superobk/microduck-cad/projects/microduck-stand/README.md

# Microduck Stand

用于 Microduck 的静态支承、姿态检查和校准准备工装。

| 版本 | 适配与状态 | 入口 |
| --- | --- | --- |
| JIG-190 R5 Compact Full15 / R5.0-rc1 | 完整 15 舵机；190 × 190 mm 底座；数字样机候选版 | [打印文件与中文使用说明](r5-compact-full15/README.md) |

R5 与 R4 接口和脚高不同，请使用同一版本目录中的全套零件。后续版本在本目录新增独立子目录，并更新本表。
