superobk/microduck-cad/projects/microduck-stand/r5-compact-full15/stl/01_integrated_main_190.stl

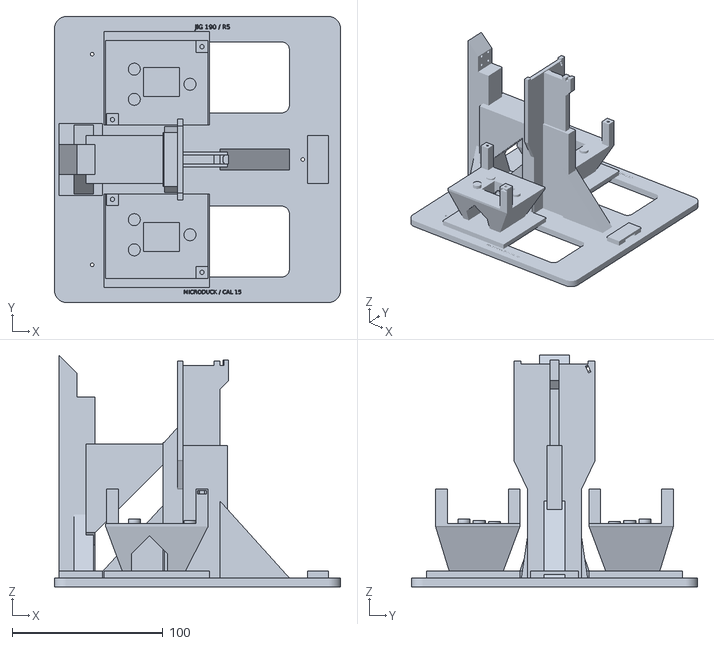
[picture p3: CAD file, 2026-11-02]
projects/microduck-stand/r5-compact-full15/stl/01_integrated_main_190.stl
190.0 x 190.0 x 154.0
