superobk/microduck-cad/projects/microduck-stand/r5-compact-full15/printing/Microduck_JIG190_R5_P1S_PLA_PREPARE.3mf

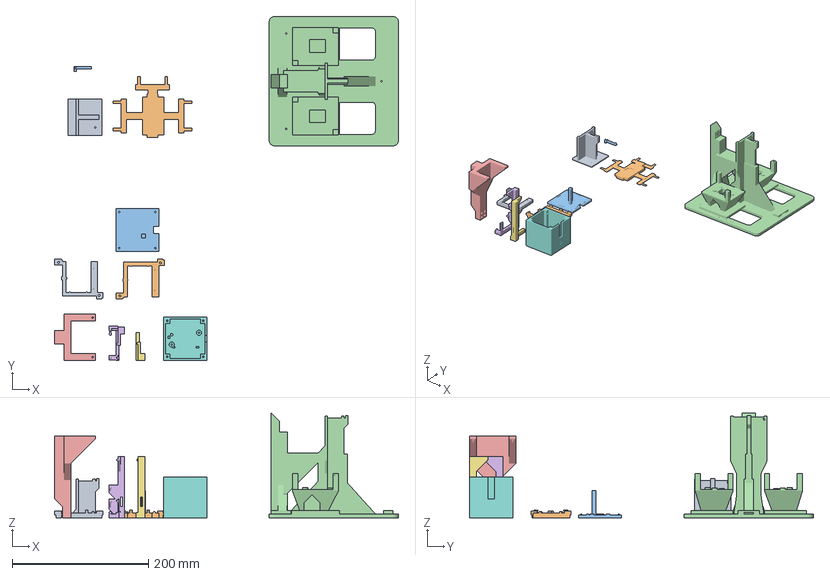
[picture p4: CAD file, 2026-11-02]
projects/microduck-stand/r5-compact-full15/printing/Microduck_JIG190_R5_P1S_PLA_PREPARE.3mf
505.2 x 505.2 x 154.0 mm
11_first_fit_coupon
08_multigauge
07_trunk_locator
01_integrated_main_190
02_upper_head_mast
03_head_locator_left
04_head_locator_right
09_imu_cube_body
05_foot_gate_left
06_foot_gate_right
10_imu_cube_lid
