superobk/microduck-cad/projects/microduck-stand/r5-compact-full15/stl/10_imu_cube_lid.stl

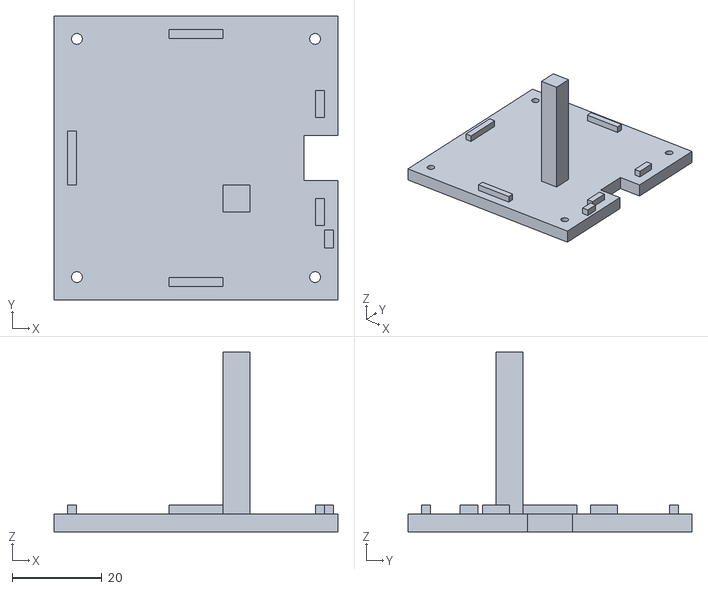
[picture p5: CAD file, 2026-11-02]
projects/microduck-stand/r5-compact-full15/stl/10_imu_cube_lid.stl
63.2 x 63.2 x 40.0
