superobk/microduck-cad/projects/microduck-stand/r5-compact-full15/stl/03_head_locator_left.stl

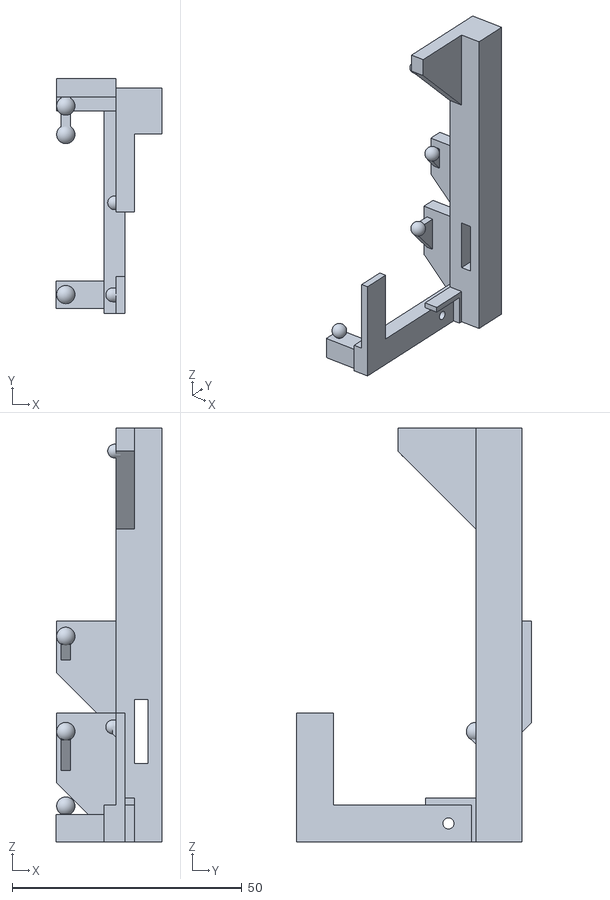
[picture p6: CAD file, 2026-11-02]
projects/microduck-stand/r5-compact-full15/stl/03_head_locator_left.stl
23.0 x 51.0 x 90.0
