superobk/microduck-cad/projects/microduck-stand/r5-compact-full15/stl/08_multigauge.stl

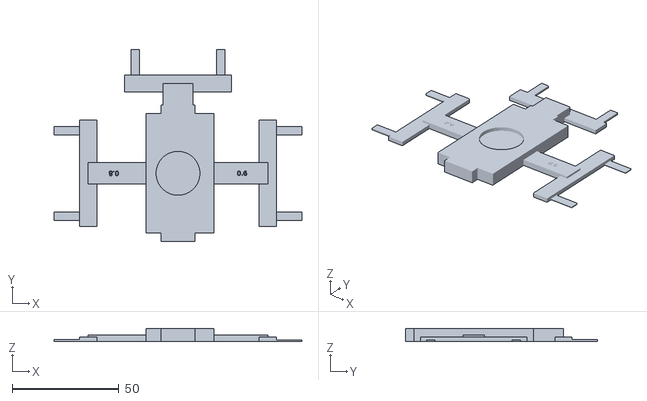
[picture p7: CAD file, 2026-11-02]
projects/microduck-stand/r5-compact-full15/stl/08_multigauge.stl
116.0 x 90.0 x 6.00
