superobk/microduck-cad/projects/microduck-stand/r5-compact-full15/stl/04_head_locator_right.stl

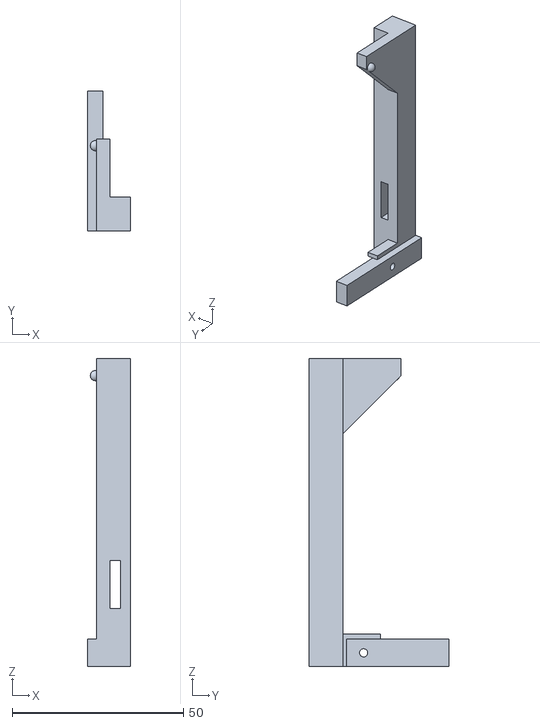
[picture p8: CAD file, 2026-11-02]
projects/microduck-stand/r5-compact-full15/stl/04_head_locator_right.stl
12.6 x 41.0 x 90.0
