superobk/microduck-cad/projects/microduck-stand/r5-compact-full15/stl/07_trunk_locator.stl

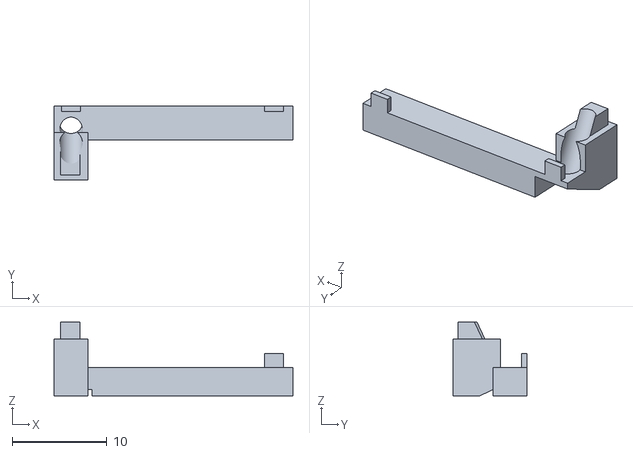
[picture p9: CAD file, 2026-11-02]
projects/microduck-stand/r5-compact-full15/stl/07_trunk_locator.stl
25.2 x 7.80 x 7.80
