superobk/microduck-cad/projects/microduck-stand/r5-compact-full15/stl/02_upper_head_mast.stl

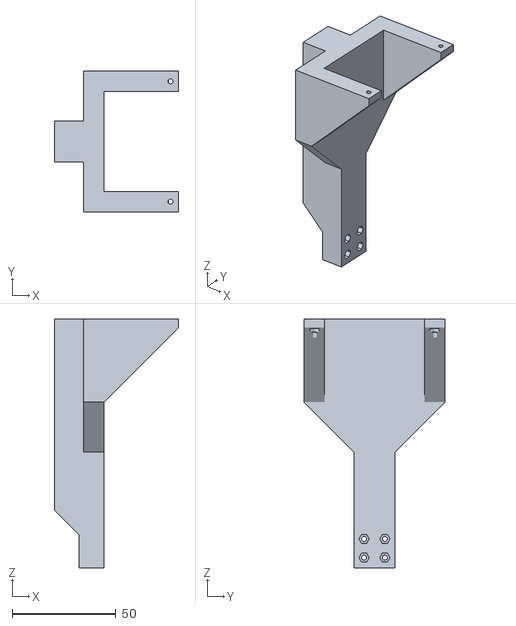
[picture p10: CAD file, 2026-11-02]
projects/microduck-stand/r5-compact-full15/stl/02_upper_head_mast.stl
60.0 x 68.0 x 120.0
