superobk/microduck-cad/projects/microduck-stand/r5-compact-full15/stl/06_foot_gate_right.stl

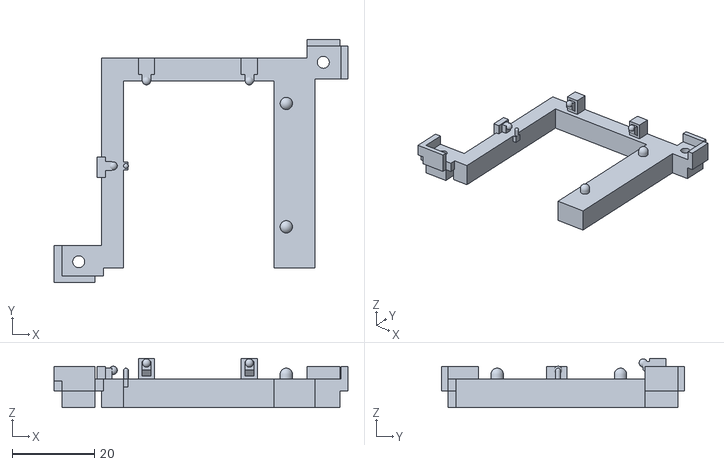
[picture p11: CAD file, 2026-11-02]
projects/microduck-stand/r5-compact-full15/stl/06_foot_gate_right.stl
71.5 x 59.0 x 12.0
