superobk/microduck-cad/projects/microduck-stand/r5-compact-full15/stl/09_imu_cube_body.stl

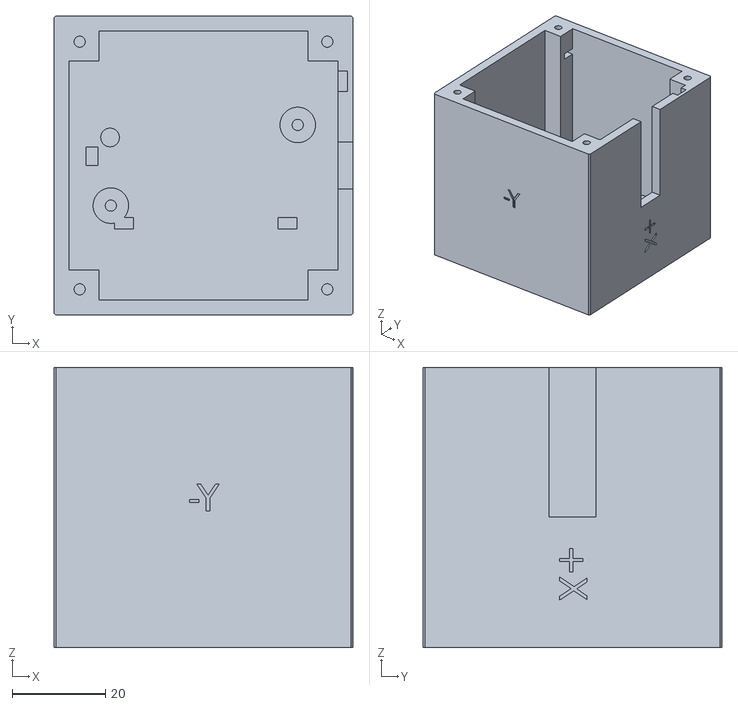
[picture p12: CAD file, 2026-11-02]
projects/microduck-stand/r5-compact-full15/stl/09_imu_cube_body.stl
64.0 x 64.0 x 60.0
