superobk/microduck-cad/projects/microduck-stand/r5-compact-full15/stl/11_first_fit_coupon.stl

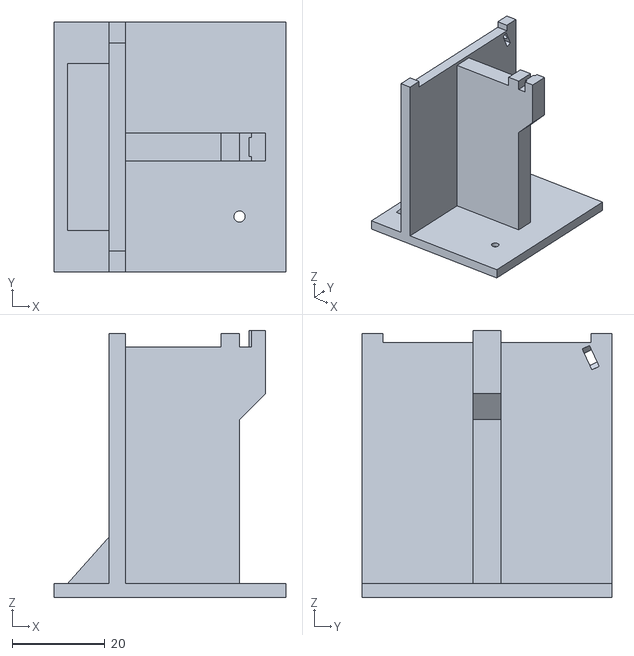
[picture p13: CAD file, 2026-11-02]
projects/microduck-stand/r5-compact-full15/stl/11_first_fit_coupon.stl
50.0 x 54.0 x 57.6
