superobk/microduck-cad/(list of files, cad)

Other CAD files:
projects/microduck-stand/r5-compact-full15/stl/05_foot_gate_left.stl
